0xnofoot/WorkPlace-Picture/pic/·.jpg

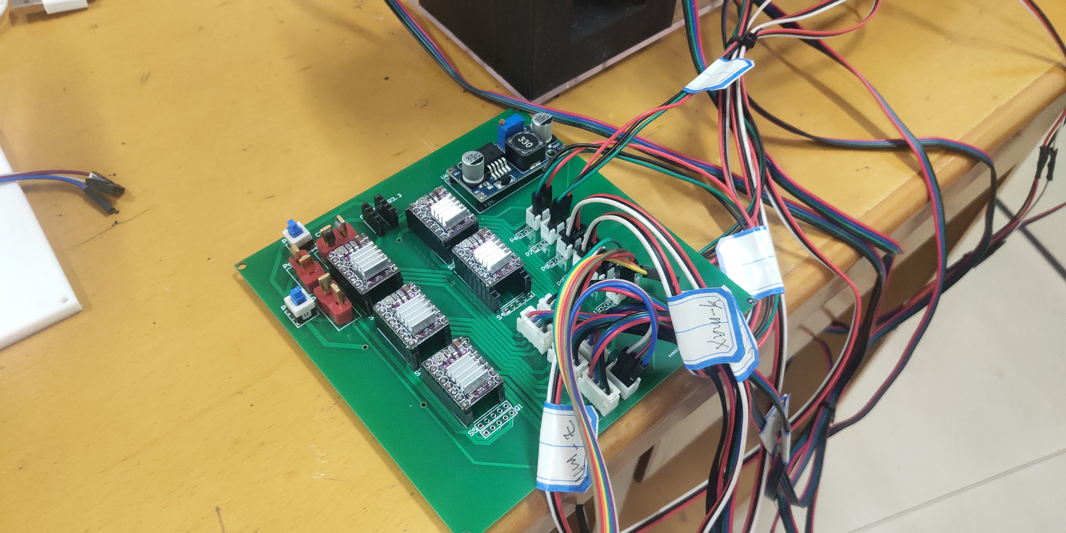
pic/·.jpg
