0xnofoot/WorkPlace-Picture/pic/3.jpg

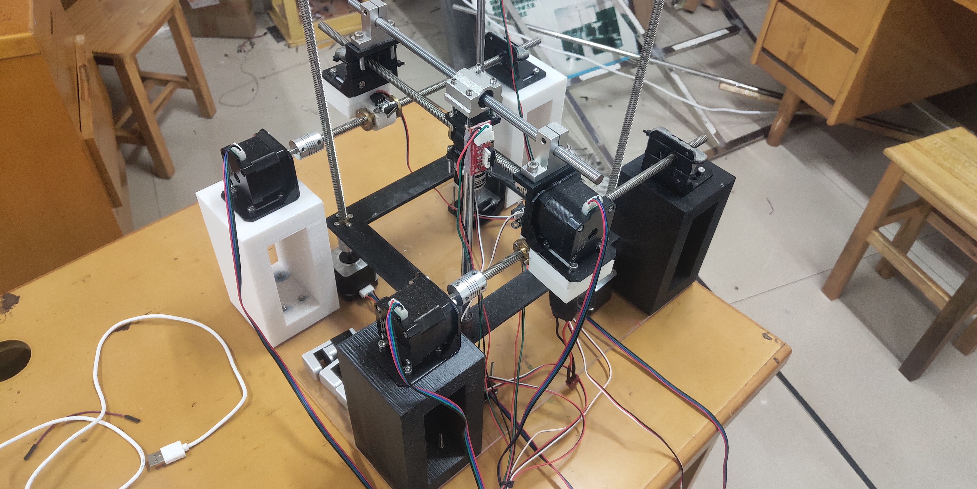
pic/3.jpg
