0xnofoot/WorkPlace-Picture/README.md

# -
图像识别工作台————
该系统可以识别PC端的绘图数据，并将该数据通过串口送至下位机，下位机再控制步进电机等硬件设备在木板中切割出对应图形。
