0xnofoot/WorkPlace-Picture/pic/2.jpg

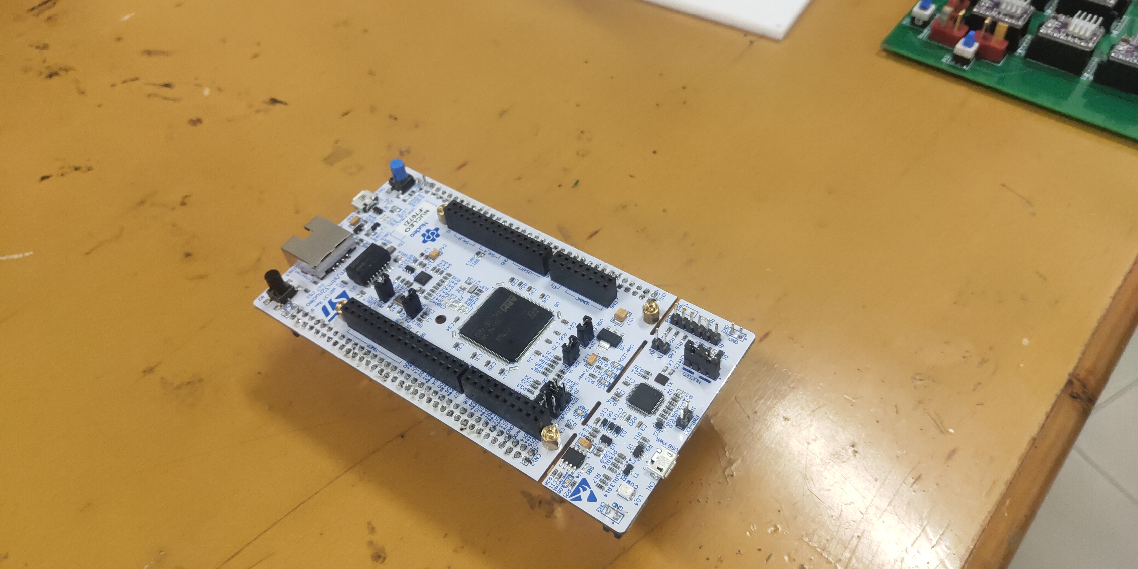
pic/2.jpg
