0xnofoot/WorkPlace-Picture/pic/4.jpg

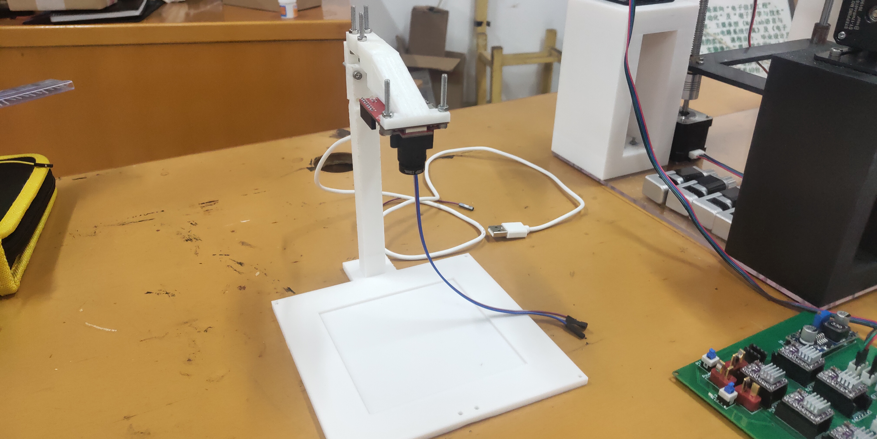
pic/4.jpg
