0xnofoot/WorkPlace-Picture/(list of files, cad)

Other CAD files:
3D Model/测试1_丝杆电机座连接件.dwg
3D Model/测试2_滑块平面图.dwg
3D Model/摄像头顶部连接件.dwg
3D Model/升降台.dwg
3D Model/high_test.dwg
3D Model/丝杆螺母连接件.dwg
3D Model/motor_hold.dwg
3D Model/测试2_滑块轴承立体.dwg
3D Model/木板.dwg
3D Model/支柱1_6孔.dwg
3D Model/备用图.dwg
3D Model/摄像头中间连接件.dwg
3D Model/联轴器固定.dwg
3D Model/摄像头底板.dwg
3D Model/motor_test.dwg
3D Model/上层连接件.dwg
3D Model/支柱2_2孔.dwg
