0xnofoot/WorkPlace-Picture/源码/WorkPlace_Picture/WorkPlace_Picture.ioc

Mcu.UserName=STM32F767ZITx
PA0/WKUP.Signal=SYS_WKUP1
PA1.Signal=ETH_REF_CLK
PA10.Signal=USB_OTG_FS_ID
PA11.Signal=USB_OTG_FS_DM
PA12.Signal=USB_OTG_FS_DP
PA13.Signal=SYS_JTMS-SWDIO
PA14.Signal=SYS_JTCK-SWCLK
PA15.Signal=S_TIM2_CH1_ETR
PA2.Signal=ETH_MDIO
PA3.Signal=GPIO_Output
PA5.Signal=SPI1_SCK
PA6.Signal=SPI1_MISO
PA7.Signal=ETH_CRS_DV
PA8.Signal=USB_OTG_FS_SOF
PA9.Signal=USB_OTG_FS_VBUS
PB13.Signal=ETH_TXD1
PB3.Signal=SYS_JTDO-SWO
PB7.Signal=GPIO_Output
PC1.Signal=ETH_MDC
PC10.Signal=UART4_TX
PC11.Signal=UART4_RX
PC13.Signal=GPXTI13
PC14/OSC32_IN.Signal=RCC_OSC32_IN
PC15/OSC32_OUT.Signal=RCC_OSC32_OUT
PC4.Signal=ETH_RXD0
PC5.Signal=ETH_RXD1
PC6.Signal=S_TIM3_CH1
PD12.Signal=S_TIM4_CH1
PD7.Signal=SPI1_MOSI
PD8.Signal=USART3_TX
PD9.Signal=USART3_RX
PE0.Signal=GPIO_Output
PE1.Signal=GPIO_Output
PE5.Signal=S_TIM9_CH1
PF10.Signal=GPIO_Input
PF11.Signal=GPIO_Output
PF12.Signal=GPIO_Output
PF13.Signal=GPIO_Output
PF6.Signal=GPIO_Input
PF7.Signal=GPIO_Input
PF8.Signal=GPIO_Input
PF9.Signal=GPIO_Input
PG11.Signal=ETH_TX_EN
PG13.Signal=ETH_TXD0
PG6.Signal=GPIO_Output
PH0/OSC_IN.Signal=RCC_OSC_IN
PH1/OSC_OUT.Signal=RCC_OSC_OUT
