0xnofoot/WorkPlace-Picture/源码/WorkPlace_Picture/User/Lcd_Driver.c

#include "Lcd_Driver.h"

/****************************************************************************
* 名    称：u8 SPI_WriteByte(SPI_TypeDef* SPIx,u8 Byte)
* 功    能：STM32_硬件SPI读写一个字节数据底层函数
* 入口参数：Byte
* 出口参数：返回总线收到的数据
* 说    明：STM32_硬件SPI读写一个字节数据底层函数
****************************************************************************/
void SPI_WriteByte(uint8_t TxData)
{
  HAL_SPI_Transmit(&hspi1,&TxData,1,10);
} 



/****************************************************************************
* 名    称：void Lcd_WriteIndex(u8 idx)
* 功    能：写 ST7735S 控制器寄存器地址
* 入口参数：idx   寄存器地址
* 出口参数：无
* 说    明：调用前需先选中控制器，内部函数
* 调用方法：Lcd_WriteIndex(0x00);
****************************************************************************/
void Lcd_WriteIndex(uint8_t Index)
{
   //SPI 写命令时序开始
   LCD_CS_CLR;
   LCD_RS_CLR;
	 SPI_WriteByte(Index); 
   LCD_CS_SET;
}

/****************************************************************************
* 名    称：void Lcd_WriteData(u8 dat)
* 功    能：写 ST7735S 寄存器数据
* 入口参数：dat     寄存器数据
* 出口参数：无
* 说    明：向控制器指定地址写入数据，调用前需先写寄存器地址，内部函数
* 调用方法：Lcd_WriteData(0x30)
****************************************************************************/
void Lcd_WriteData(uint8_t Data)
{

   LCD_CS_CLR;
   LCD_RS_SET; 
	 SPI_WriteByte(Data);	 
   LCD_CS_SET; 
}

void Lcd_WriteReg(uint8_t Index,uint8_t Data)
{
	Lcd_WriteIndex(Index);
  Lcd_WriteData(Data);
}

void Lcd_Reset(void)
{
//	LCD_RST_CLR;
	  delay_ms(100);
//	LCD_RST_SET;
	  delay_ms(100);
}


//管理LCD重要参数
//默认为竖屏
_lcd_dev lcddev;

//设置LCD参数
//方便进行横竖屏模式切换
void LCD_SetParam(void)
{ 	
	lcddev.wramcmd=0x2C;
	lcddev.dir=0;//竖屏				 	 		
	lcddev.width=128;
	lcddev.height=160;
	lcddev.setxcmd=0x2A;
	lcddev.setycmd=0x2B;	
	Lcd_WriteReg(0x36,0xC0);
}


/*************************************************
函数名：LCD_Set_Region
功能：设置lcd显示区域，在此区域写点数据自动换行
入口参数：xy起点和终点,Y_IncMode表示先自增y再自增x
返回值：无
*************************************************/
void Lcd_SetRegion(uint16_t x_start,uint16_t y_start,uint16_t x_end,uint16_t y_end)
{

	Lcd_WriteIndex(0x2a);
	Lcd_WriteData(0x00);
	Lcd_WriteData(x_start);
	Lcd_WriteData(0x00);
	Lcd_WriteData(x_end);

	Lcd_WriteIndex(0x2b);
	Lcd_WriteData(0x00);
	Lcd_WriteData(y_start);
	Lcd_WriteData(0x00);
	Lcd_WriteData(y_end);
	
	Lcd_WriteIndex(0x2c); //开始写入GRAM

}

/*************************************************
函数名：LCD_Set_XY
功能：设置lcd显示起始点
入口参数：xy坐标
返回值：无
*************************************************/
void Lcd_SetXY(uint16_t x,uint16_t y)
{
	  Lcd_SetRegion(x+2,y+1,x+2,y+1);
}

	
/*************************************************
函数名：LCD_DrawPoint
功能：画一个点
入口参数：无
返回值：无
*************************************************/
void Gui_DrawPoint(uint16_t x,uint16_t y,uint16_t Data)
{
	
	Lcd_SetRegion(x+2,y+1,x+3,y+2);
	Lcd_WriteData(Data>>8);
	Lcd_WriteData(Data);

}    

/*************************************************
函数名：Lcd_Clear
功能：全屏清屏函数
入口参数：填充颜色COLOR
返回值：无
*************************************************/
void Lcd_Clear(uint16_t Color)               
{	
   unsigned int i,m;

   Lcd_SetRegion(2,1,X_MAX_PIXEL+1,Y_MAX_PIXEL);
	
   Lcd_WriteIndex(0x2C);
	
 	for(i=0;i<Y_MAX_PIXEL;i++)
    for(m=0;m<X_MAX_PIXEL;m++)
    {	
	  	Lcd_WriteData(Color>>8);
			Lcd_WriteData(Color);
    } 		
}

void Lcd_Init(void)
{

	  Lcd_Reset();
    
		Lcd_WriteIndex(0x11);//Sleep exit 
		
		delay_ms (300);
			
		Lcd_WriteIndex(0xB1); 
		Lcd_WriteData(0x05); 
		Lcd_WriteData(0x3C); 
		Lcd_WriteData(0x3C); 
		Lcd_WriteIndex(0xB2); 
		Lcd_WriteData(0x05); 
		Lcd_WriteData(0x3C); 
		Lcd_WriteData(0x3C); 
		Lcd_WriteIndex(0xB3); 
		Lcd_WriteData(0x05); 
		Lcd_WriteData(0x3C); 
		Lcd_WriteData(0x3C); 
		Lcd_WriteData(0x05); 
		Lcd_WriteData(0x3C); 
		Lcd_WriteData(0x3C); 
		//------------------------------------End ST7735S Frame Rate---------------------------------// 
		Lcd_WriteIndex(0xB4); //Dot inversion 
		Lcd_WriteData(0x03); 
		//------------------------------------ST7735S Power Sequence---------------------------------// 
		Lcd_WriteIndex(0xC0); 
		Lcd_WriteData(0x28); 
		Lcd_WriteData(0x08); 
		Lcd_WriteData(0x04); 
		Lcd_WriteIndex(0xC1); 
		Lcd_WriteData(0XC0); 
		Lcd_WriteIndex(0xC2); 
		Lcd_WriteData(0x0D); 
		Lcd_WriteData(0x00); 
		Lcd_WriteIndex(0xC3); 
		Lcd_WriteData(0x8D); 
		Lcd_WriteData(0x2A); 
		Lcd_WriteIndex(0xC4); 
		Lcd_WriteData(0x8D); 
		Lcd_WriteData(0xEE); 
		//---------------------------------End ST7735S Power Sequence-------------------------------------// 
		Lcd_WriteIndex(0xC5); //VCOM 
		Lcd_WriteData(0x1A); 
		Lcd_WriteIndex(0x36); //MX, MY, RGB mode 
		Lcd_WriteData(0xC0); 
		//------------------------------------ST7735S Gamma Sequence---------------------------------// 
		Lcd_WriteIndex(0xE0); 
		Lcd_WriteData(0x04); 
		Lcd_WriteData(0x22); 
		Lcd_WriteData(0x07); 
		Lcd_WriteData(0x0A); 
		Lcd_WriteData(0x2E); 
		Lcd_WriteData(0x30); 
		Lcd_WriteData(0x25); 
		Lcd_WriteData(0x2A); 
		Lcd_WriteData(0x28); 
		Lcd_WriteData(0x26); 
		Lcd_WriteData(0x2E); 
		Lcd_WriteData(0x3A); 
		Lcd_WriteData(0x00); 
		Lcd_WriteData(0x01); 
		Lcd_WriteData(0x03); 
		Lcd_WriteData(0x13); 
		Lcd_WriteIndex(0xE1); 
		Lcd_WriteData(0x04); 
		Lcd_WriteData(0x16); 
		Lcd_WriteData(0x06); 
		Lcd_WriteData(0x0D); 
		Lcd_WriteData(0x2D); 
		Lcd_WriteData(0x26); 
		Lcd_WriteData(0x23); 
		Lcd_WriteData(0x27); 
		Lcd_WriteData(0x27); 
		Lcd_WriteData(0x25); 
		Lcd_WriteData(0x2D); 
		Lcd_WriteData(0x3B); 
		Lcd_WriteData(0x00); 
		Lcd_WriteData(0x01); 
		Lcd_WriteData(0x04); 
		Lcd_WriteData(0x13); 
		//------------------------------------End ST7735S Gamma Sequence-----------------------------// 
		Lcd_WriteIndex(0x3A); //65k mode 
		Lcd_WriteData(0x05); 
		Lcd_WriteIndex(0x29); //Display on 

    LCD_SetParam();//设置LCD参数	 
}
