0xnofoot/WorkPlace-Picture/源码/WorkPlace_Picture/User/State_Show.h

#ifndef __STATE_SHOW_H
#define __STATE_SHOW_H

#include "main.h"
#include "Lcd_Driver.h"
#include "GUI.h"

void State_Show_Init(void);
void Place_Show(uint16_t X,uint16_t Y);

#endif /*__STATE_SHOW_H*/
