0xnofoot/WorkPlace-Picture/源码/WorkPlace_Picture/User/Delay.c

#include "Delay.h"

void delay_us(uint16_t us)
{
	uint16_t differ=0xffff-us-5;
	
	HAL_TIM_Base_Start(&htim14);
	
	__HAL_TIM_SetCounter(&htim14,differ);
	
	while(differ < 0xffff-5)
	{
		differ = __HAL_TIM_GetCounter(&htim14);
	}
	
	HAL_TIM_Base_Stop(&htim14);
}
